nppc/ChillerControl/Firmware/CASCADE_LOGIC.md

# Внешний температурный контур

Внешний контур преобразует уставку жидкости `setTemp` в целевую температуру
воздуха в ящике `effectiveBoxTarget`. При активном iSpindel температура жидкости
является процессной величиной. Внутренние контуры нагрева и охлаждения следуют
за `effectiveBoxTarget` и этим документом не описываются.

Реализация находится в `CoolerBox/TemperatureControl.cpp`. Отчёты iSpindel
поступают из `CoolerBox/CoolerBox.cpp`; статусные поля сохраняют прежний внешний
интерфейс.

## Последовательность управления

1. `updateCascadeTarget()` обновляет рампу `setTemp` и фильтр скорости жидкости.
   Рампа и фильтр тренда работают как прежде.
2. PID внешнего контура запускается только при активном iSpindel и только один
   раз на новый отчёт. Повторный вызов `updateCascadeTarget()` для того же
   отчёта не меняет интеграл.
3. Цель воздуха проходит прежний ограничитель скорости изменения перед
   присваиванием `effectiveBoxTarget`.
4. Выбор режимов, блокировки и управление внутренними контурами в
   `processControl()` не менялись.

## Формула ПИД

Обозначения:

- `T` — `iSpindelTemperature`;
- `e = setTemp - T`;
- `rate` — отфильтрованная скорость изменения температуры жидкости, °C/ч;
- `I` — интегральная сумма QuickPID, соответствующая смещению воздуха относительно уставки.

Для нового отчёта:

```text
u_pi = outerPID_kP * e + I
u_d  = -outerPID_kP * clamp(outerPID_tdHours * rate,
                            -outerPID_forecastLimitC,
                            +outerPID_forecastLimitC)
u    = clamp(u_pi + u_d, -cascadeMaxOffset, +cascadeMaxOffset)
targetRaw = setTemp + u
```

Для P и I используется QuickPID в режиме `timer`, с `pOnError`, `dOnMeas`,
`iAwClamp` и прямым действием. Встроенный D отключён; D по фильтрованной скорости
рассчитывается отдельно. Перед каждым `Compute()` коэффициент Ki задаётся как
`outerPID_kIPerHour * dtHours`. `dtHours` вычисляется по времени между
обработанными отчётами и ограничивается снизу 30 секундами, сверху — 1.5
интервала iSpindel. Для первого отчёта используется настроенный интервал
iSpindel. Такой расчёт не использует микросекундный интервал QuickPID для
измерения фактического времени.

## Интегратор и состояния

- Начальное смещение `I` берётся из `boxTemp - setTemp`, ограниченного
  `±cascadeMaxOffset`. Если температура ящика ещё невалидна, начальное смещение
  равно нулю; при появлении валидного `boxTemp` интегратор инициализируется
  повторно. При переходе `useISpindelTemp` из `false` в `true` начальное
  смещение также считывается из текущего `boxTemp`.
- Смена `setTemp`, в том числе из-за шага рампы, сама по себе не сбрасывает
  интегратор.
- При активном iSpindel, если нового отчёта нет, сохраняется последний выход
  внешнего контура. Если iSpindel включён, но неактивен, цель равна
  `setTemp + I`; P и D не рассчитываются и интегратор не меняется.
- При выключенном `useISpindelTemp` цель напрямую равна `setTemp`; состояние
  PID сохраняется.
- Интегрирование замораживается, если направление, соответствующее знаку
  ошибки, недоступно, выполняется autotune нагрева либо жидкость достаточно
  быстро движется к цели (`e * rate > 0` и `abs(rate) > 0.1 °C/ч`). P и D при
  этом продолжают работать, а накопленная сумма I восстанавливается после
  `Compute()`.
- На каждом новом отчёте в Debug записываются ошибка, скорость, P, I, D,
  итоговое смещение и причина заморозки.

## Фильтр скорости и прогноз

На каждом новом активном отчёте фильтр скорости рассчитывает изменение
температуры в час, ограничивает исходную скорость диапазоном ±0.75 °C/ч и
обновляет экспоненциальное среднее с весом нового значения 0.15. При пропуске,
превышающем прежний допустимый интервал выборки, скорость сбрасывается в ноль.
Публичный `getPredictedFermenterTemp()` возвращает текущую температуру плюс
ограниченный прогноз `outerPID_tdHours * rate`.

## Совместимость публичного интерфейса

Сигнатуры и вызывающие их поверхности сохранены:

- `getHeatingCascadeGain()` и `getCoolingCascadeGain()` возвращают общий
  `outerPID_kP`;
- `getCascadeBoxBaseline()` возвращает `setTemp + I`;
- `cascadeMaxOffset`, `effectiveBoxTarget`, `iSpindelIntervalSec`, API рампы и
  остальные публичные функции не переименованы.

Проверка валидности iSpindel, выбор подрежима Auto и аварийные блокировки
сохранены без изменений на этапе 1. Значение температуры iSpindel 0 °C
допускается, если соблюдены диапазон и таймаут активности. Дополнительные
защиты и изменения режимов из этапа 2 здесь не реализованы.

## Настраиваемые параметры

Параметры внешнего PID и предел смещения задаются на странице PID, сохраняются
в EEPROM и проверяются по допустимым диапазонам. Для отключения D задайте
`outerPID_tdHours = 0`. Вклад D вычисляется вручную:
`-Kp * clamp(Td * rate, ±forecastLimit)`, поэтому `Td` задаёт горизонт
прогноза, а `forecastLimit` ограничивает прогнозную составляющую.

| Параметр | Начальное значение | Допустимый диапазон | Назначение |
| --- | ---: | --- |
| `outerPID_kP` | 2.0 | 0.1–10.0 | Пропорциональное усиление |
| `outerPID_kIPerHour` | 0.4 /ч | 0.001–2.0 /ч | Скорость интегрирования |
| `outerPID_tdHours` | 0.5 ч | 0–6.0 ч | Горизонт D-прогноза |
| `outerPID_forecastLimitC` | 0.25 °C | 0–2.0 °C | Ограничение D-прогноза |
| `outerPID_freezeRateCPerHour` | 0.1 °C/ч | 0–2.0 °C/ч | Порог скорости для заморозки I |
| `cascadeMaxOffset` | 4.0 °C | 1–10 °C | Предел смещения цели воздуха |
| `FERMENTER_MAX_RATE_C_PER_HOUR` | 0.75 °C/ч | — | Ограничение исходной скорости фильтра |
| `FERMENTER_RATE_FILTER_ALPHA` | 0.15 | — | Вес новой выборки фильтра |
| `BOX_TARGET_MAX_SLEW_UP_PER_SEC` | 0.08 °C/мин | — | Прежний предел роста цели воздуха |
| `BOX_TARGET_MAX_SLEW_DOWN_PER_SEC` | 0.12 °C/мин | — | Прежний предел снижения цели воздуха |
