nppc/ChillerControl/Images/componentsPlacement1.png

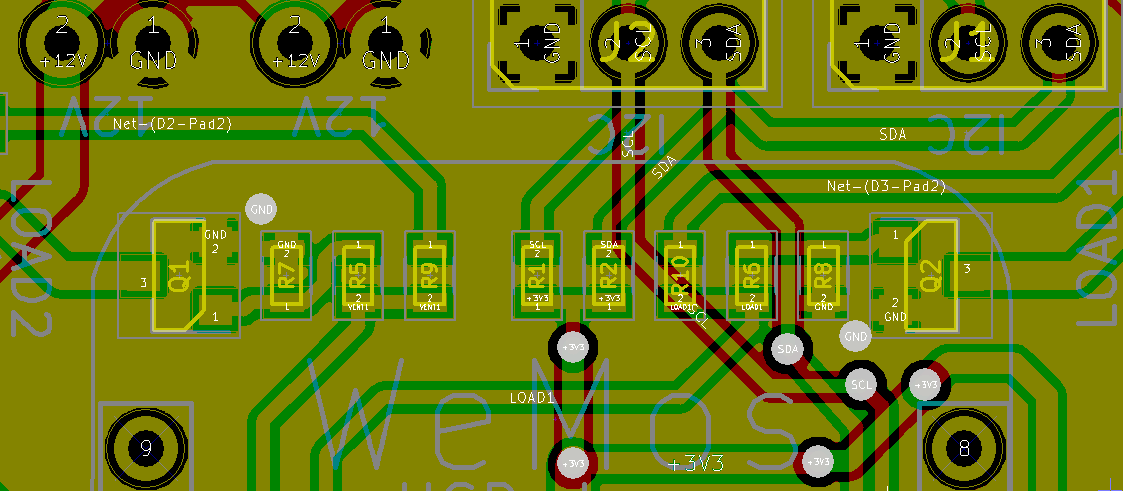
Images/componentsPlacement1.png
