nppc/ChillerControl/OpenSCAD/CoolerCover.stl

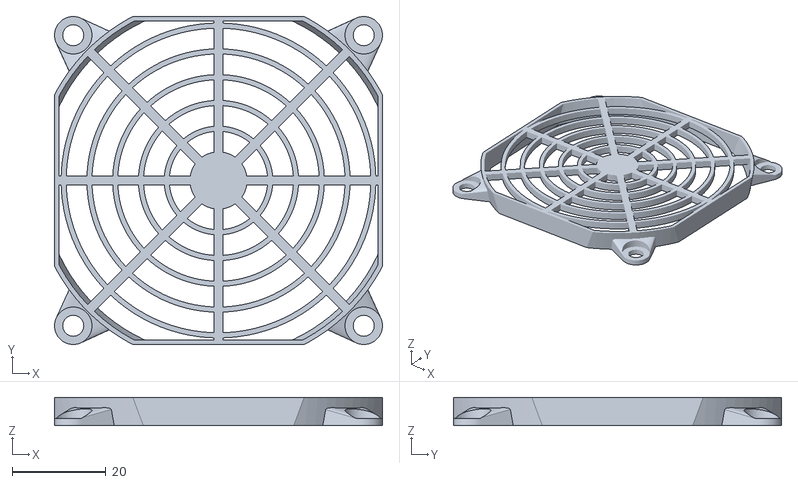
[picture p2: CAD file, 2018-10-02]
OpenSCAD/CoolerCover.stl
70.0 x 70.0 x 6.00
