nppc/ChillerControl/OpenSCAD/Lock.stl

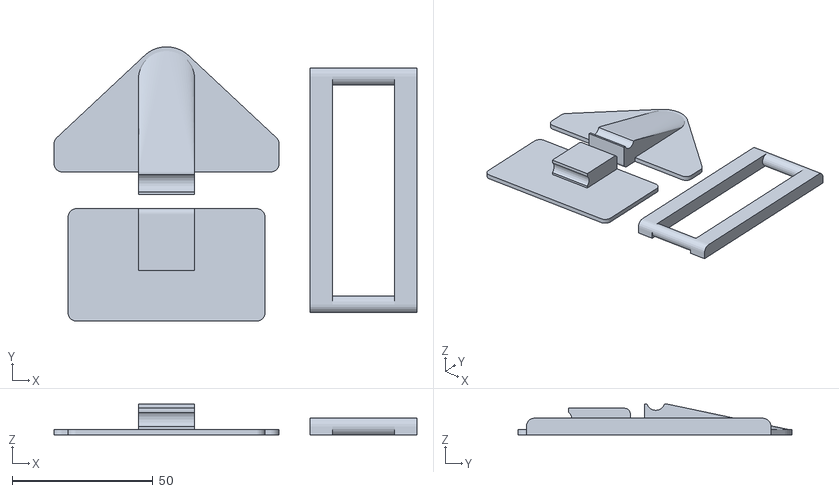
[picture p3: CAD file, 2018-09-29]
OpenSCAD/Lock.stl
129.0 x 97.5 x 11.0
