nppc/ChillerControl/OpenSCAD/CaseB.stl

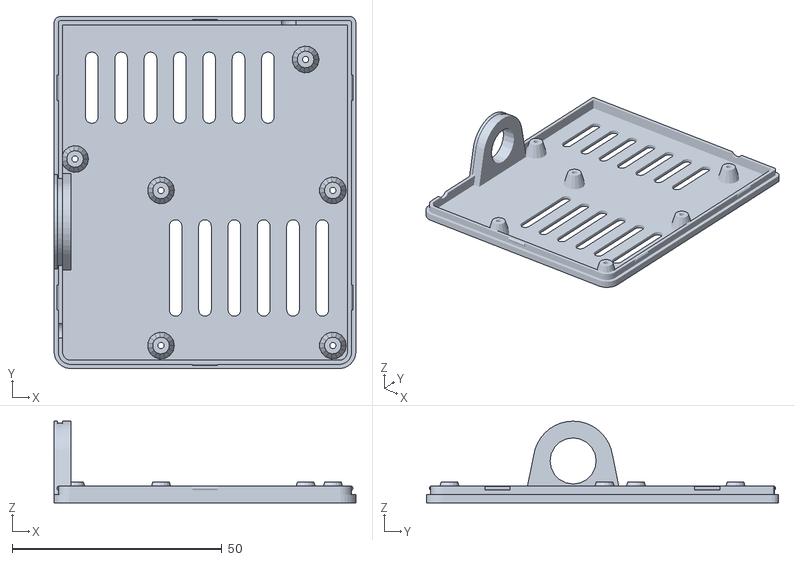
[picture p4: CAD file, 2018-09-15]
OpenSCAD/CaseB.stl
72.0 x 84.0 x 19.5
