nppc/ChillerControl/OpenSCAD/CaseT.stl

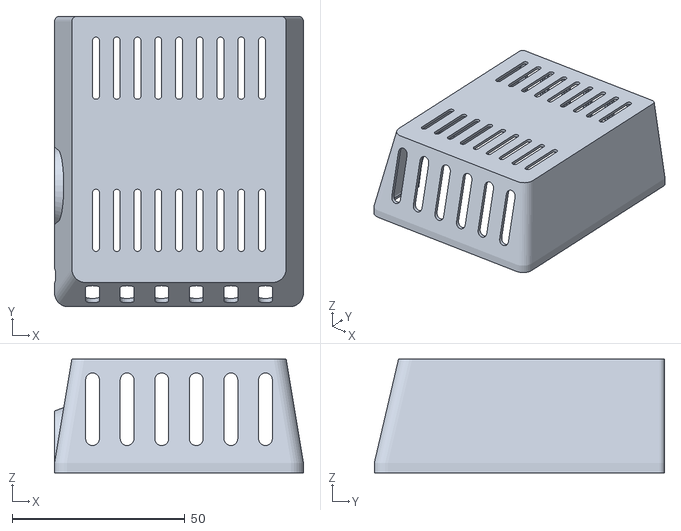
[picture p5: CAD file, 2018-09-15]
OpenSCAD/CaseT.stl
72.0 x 84.0 x 32.9
