nppc/ChillerControl/KiCad/Schematic.pdf

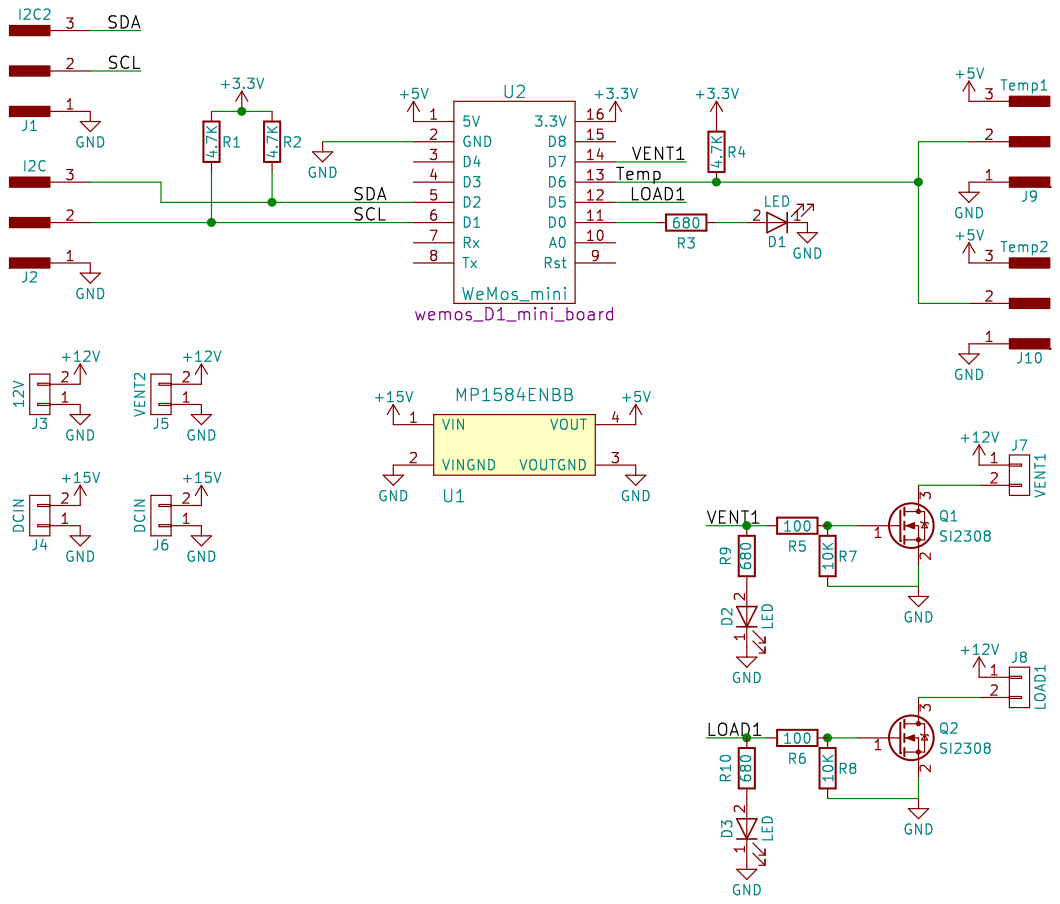
[picture p6: page 1]
