nppc/ChillerControl/KiCad/ChillerControl.kicad_pcb

## KiCad design KiCad/ChillerControl.kicad_pcb (2018-08-06)

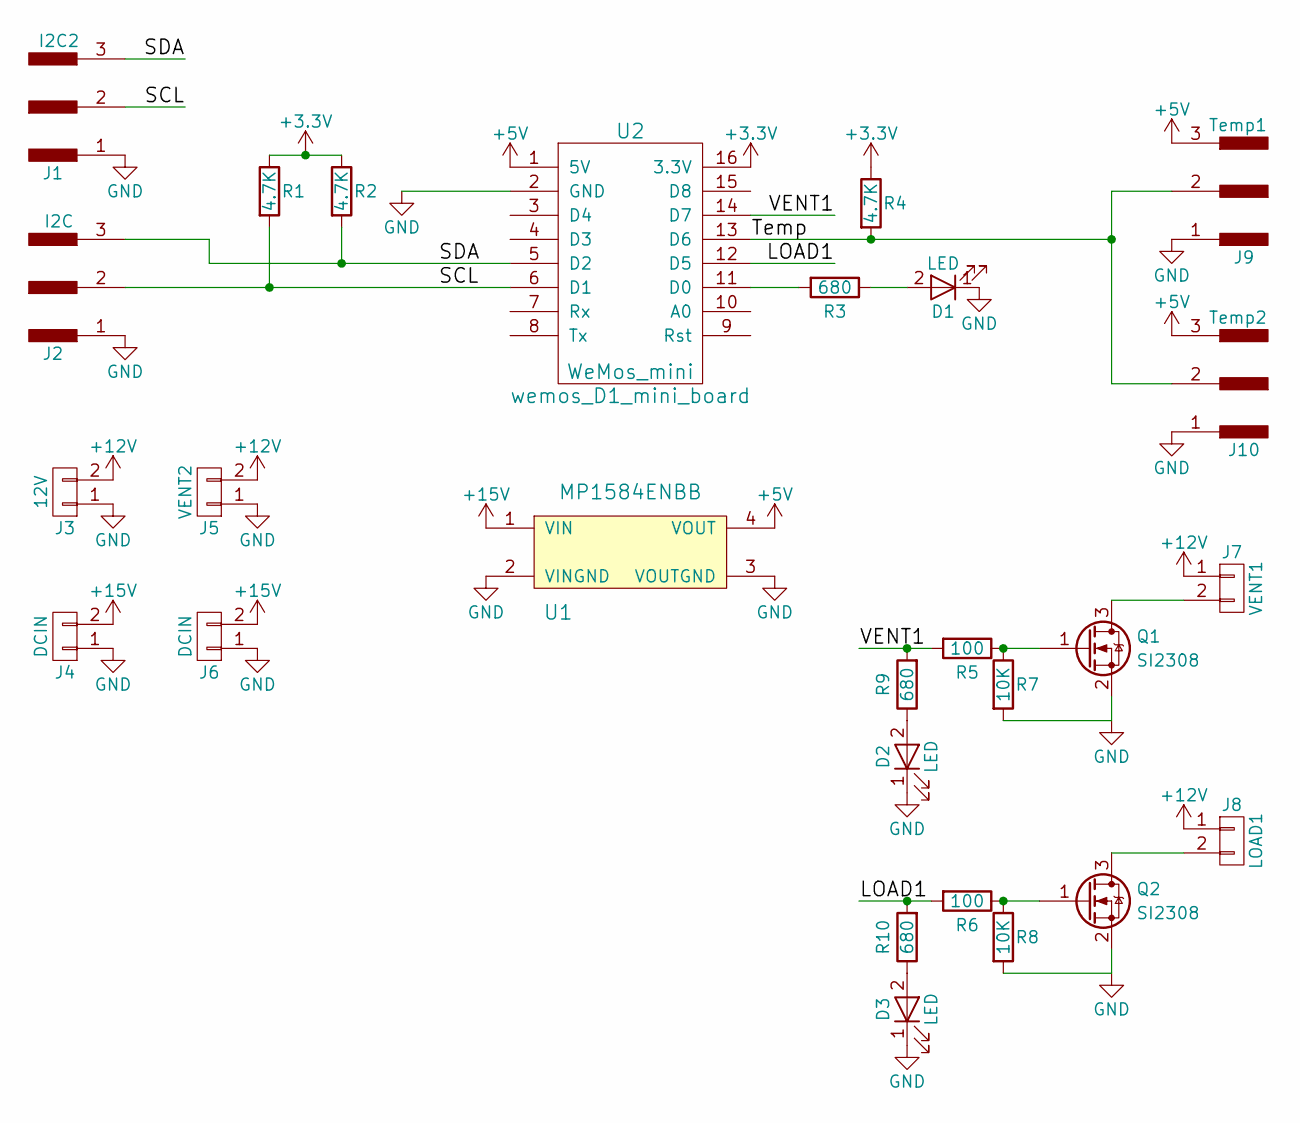
[picture p7: schematic ChillerControl-2019-03-04-20-39-42.sch]

Parts:
D1, D2, D3: LED; LED_0805
J1: I2C2; Pin_Header_Straight_1x03_Pitch2.54mm
J2: I2C; Pin_Header_Straight_1x03_Pitch2.54mm
J3: 12V; Conn2pin_2.54mm
J4, J6: DCIN; Conn_Power
J5: VENT2; Conn2pin_2.54mm
J7: VENT1; Conn2pin_2.54mm
J8: LOAD1; Conn2pin_2.54mm
J9: Temp1; Pin_Header_Straight_1x03_Pitch2.54mm
J10: Temp2; Pin_Header_Straight_1x03_Pitch2.54mm
Q1, Q2: SI2308; SOT-23
R1, R2, R4: 4.7K; R_0603
R3, R9, R10: 680; R_0603
R5, R6: 100; R_0603
R7, R8: 10K; R_0603
U1: MP1584ENBB; MP1584_buck_module
U2: WeMos_mini; wemos_D1_mini_board

Connections:
+3V3: R1.1, R2.1, R4.1, U2.16 (3.3V)
+5V: J9.3, J10.3, U1.4 (VOUT), U2.1 (5V)
+12V: J3.2, J5.2, J7.1, J8.1
+15V: J4.2, J6.2, U1.1 (VIN)
/LOAD1: R6.2, R10.2, U2.12 (D5)
/SCL: J1.2, J2.2, R1.2, U2.6 (D1)
/SDA: J1.3, J2.3, R2.2, U2.5 (D2)
/Temp: J9.2, J10.2, R4.2, U2.13 (D6)
/VENT1: R5.2, R9.2, U2.14 (D7)
GND: D1.1 (K), D2.1 (K), D3.1 (K), J1.1, J2.1, J3.1, J4.1, J5.1, J6.1, J9.1, J10.1, Q1.2 (S), Q2.2 (S), R7.2, R8.2, U1.2 (VINGND), U1.3 (VOUTGND), U2.2 (GND)
unnamed: D1.2 (A), R3.1
unnamed: D2.2 (A), R9.1
unnamed: D3.2 (A), R10.1
unnamed: J7.2, Q1.3 (D)
unnamed: J8.2, Q2.3 (D)
unnamed: Q1.1 (G), R5.1, R7.1
unnamed: Q2.1 (G), R6.1, R8.1
unnamed: R3.2, U2.11 (D0)

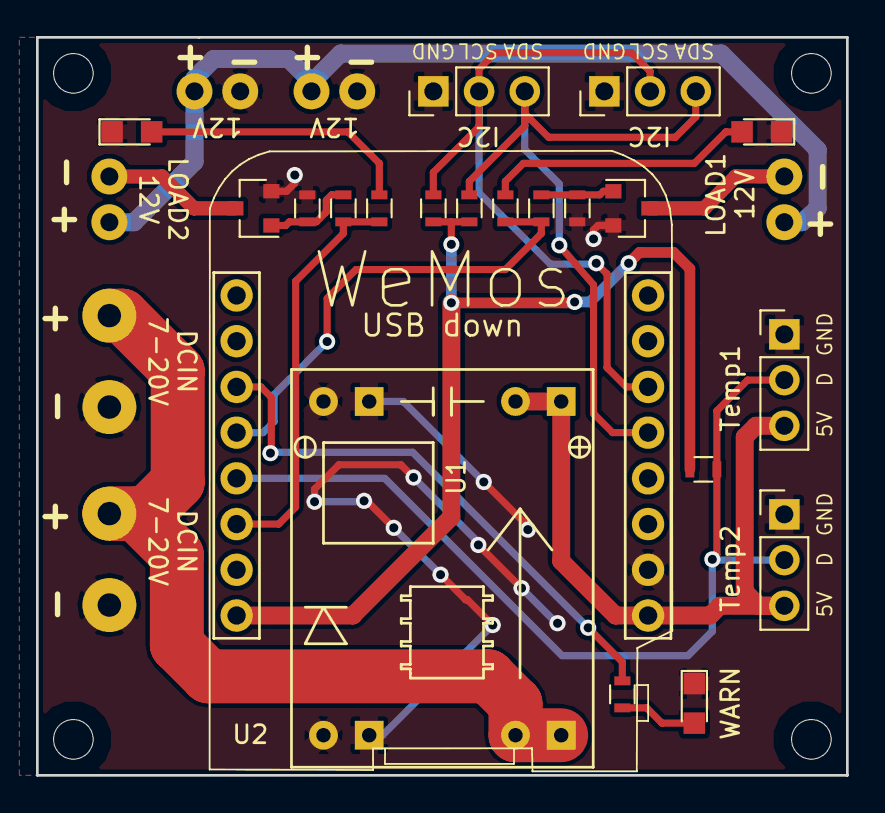
[picture p8: board ChillerControl.kicad_pcb from above]

Board: 2 copper layers, 45.0 x 41.0 mm, 27 parts (0 on the bottom side), 18 nets.
