nppc/ChillerControl/Firmware/data/main.js

let requestedSetTemp = null;
const RAMP_UP_ICON = '<svg class="target-ramp-icon" viewBox="0 0 20 20" aria-hidden="true"><path d="M3 3.5h14M4 15.5l4-3.5 3 1 4.5-7"/><path d="M12.5 6H16v3.5"/></svg>';
const RAMP_DOWN_ICON = '<svg class="target-ramp-icon" viewBox="0 0 20 20" aria-hidden="true"><path d="M3 16.5h14M4 4.5l4 3.5 3-1 4.5 7"/><path d="M12.5 14H16v-3.5"/></svg>';

function NumberChange(n, i) {
  const el = document.getElementById(i);
  if (!el) return;
  if (!el.value || el.value === '') {
    const setTempEl = document.getElementById('setTemp');
    const current = setTempEl ? parseFloat(setTempEl.textContent) : 19.0;
    el.value = (isNaN(current) ? 19.0 : current).toFixed(1);
  }
  el.stepUp(n);
}

function setupNavigation() {
  const container = document.querySelector('.container');
  if (!container) return;

  const oldHeader = container.querySelector('.hdr_table');
  const caption = oldHeader && oldHeader.querySelector('.hdr_caption');
  const header = document.createElement('header');
  header.className = 'app-header';

  const menuButton = document.createElement('button');
  menuButton.type = 'button';
  menuButton.className = 'menu-toggle';
  menuButton.id = 'menuBtn';
  menuButton.setAttribute('aria-label', 'Open navigation menu');
  menuButton.setAttribute('aria-controls', 'sideMenu');
  menuButton.setAttribute('aria-expanded', 'false');
  menuButton.textContent = '\u2630';

  const brandCopy = document.createElement('div');
  brandCopy.className = 'brand-copy';
  const brandName = document.createElement('div');
  brandName.className = 'brand-name';
  brandName.textContent = 'COOLER BOX';
  const title = document.createElement('h1');
  title.id = 'appTitle';
  title.textContent = caption ? caption.textContent.trim() : document.title;
  brandCopy.append(brandName, title);

  const headerStatus = document.createElement('div');
  headerStatus.className = 'header-status';
  headerStatus.id = 'headerStatus';
  headerStatus.innerHTML = `
    <div class="wifi-indicators">
      <div class="wifi-status signal-0" id="wifiStatus" aria-label="Box Wi-Fi disconnected" title="Box Wi-Fi">
        <svg class="wifi-icon" viewBox="0 0 32 32" aria-hidden="true">
          <path class="wifi-arc wifi-arc-outer" d="M3 11.5a19 19 0 0 1 26 0"/>
          <path class="wifi-arc wifi-arc-middle" d="M7.5 16a12.5 12.5 0 0 1 17 0"/>
          <path class="wifi-arc wifi-arc-inner" d="M12 20.5a6 6 0 0 1 8 0"/>
          <circle class="wifi-dot" cx="16" cy="25" r="2.2"/>
        </svg>
        <span class="wifi-label">Box:</span><span id="rssiValue">-- dBm</span>
      </div>
    </div>
    <div class="uptime-status"><span class="uptime-label">Up: </span><span id="CurTime">--</span></div>
  `;

  header.append(menuButton, brandCopy, headerStatus);
  container.insertBefore(header, container.firstChild);

  const menu = document.createElement('nav');
  menu.id = 'sideMenu';
  menu.setAttribute('aria-label', 'Main navigation');
  const menuHeading = document.createElement('h2');
  menuHeading.textContent = 'Menu';
  menu.appendChild(menuHeading);

  const menuItems = [
    ['Home', '/'],
    ['Settings', '/settings'],
    ['PID tuning', '/pids'],
    ['Network', '/network'],
    ['Diagnostics', '/debug'],
    ['Firmware update', '/update']
  ];
  menuItems.forEach(([label, href]) => {
    const link = document.createElement('a');
    link.className = 'menu-item';
    link.href = href;
    link.textContent = label;
    if (window.location.pathname === href ||
        (href === '/' && window.location.pathname === '/index.htm')) {
      link.setAttribute('aria-current', 'page');
    }
    menu.appendChild(link);
  });

  const backdrop = document.createElement('button');
  backdrop.type = 'button';
  backdrop.id = 'sideMenuBackdrop';
  backdrop.setAttribute('aria-label', 'Close navigation menu');
  document.body.append(menu, backdrop);

  const closeMenu = () => {
    menu.classList.remove('open');
    backdrop.classList.remove('open');
    menuButton.setAttribute('aria-expanded', 'false');
    menuButton.setAttribute('aria-label', 'Open navigation menu');
  };
  menuButton.addEventListener('click', () => {
    const isOpen = menu.classList.toggle('open');
    backdrop.classList.toggle('open', isOpen);
    menuButton.setAttribute('aria-expanded', String(isOpen));
    menuButton.setAttribute('aria-label', isOpen ? 'Close navigation menu' : 'Open navigation menu');
    if (isOpen) menu.querySelector('a').focus();
  });
  backdrop.addEventListener('click', closeMenu);
  menu.addEventListener('click', (event) => {
    if (event.target.closest('a')) closeMenu();
  });
  document.addEventListener('keydown', (event) => {
    if (event.key === 'Escape') {
      const stopModal = document.getElementById('stopModalBackdrop');
      if (stopModal && stopModal.style.display !== 'none') {
        closeStopModal();
        return;
      }
      const modal = document.getElementById('tempModalBackdrop');
      if (modal && modal.style.display !== 'none') {
        closeTempModal();
        return;
      }
      if (menu.classList.contains('open')) {
        closeMenu();
        menuButton.focus();
      }
    }
  });

  if (caption) {
    new MutationObserver(() => {
      title.textContent = caption.textContent.trim();
    }).observe(caption, { childList: true, characterData: true, subtree: true });
  }

  if (!document.getElementById('boxTemp')) {
    fetch('/status')
      .then(r => r.ok ? r.json() : null)
      .then(data => { if (data) updateHeaderStatus(data); })
      .catch(() => {});

    setInterval(() => {
      if (!document.hidden) {
        fetch('/status')
          .then(r => r.ok ? r.json() : null)
          .then(data => { if (data) updateHeaderStatus(data); })
          .catch(() => {});
      }
    }, 5000);
  }
}

function updateHeaderStatus(data) {
  const curTime = document.getElementById('CurTime');
  if (curTime && data.CurTime !== undefined) {
    curTime.textContent = data.CurTime;
  }
  const wifiStatus = document.getElementById('wifiStatus');
  const rssiValue = document.getElementById('rssiValue');
  if (wifiStatus && rssiValue) {
    const connected = data.wifiConnected === true && Number.isFinite(Number(data.rssi));
    const rssi = connected ? Number(data.rssi) : null;
    const signalLevel = !connected ? 0 : rssi >= -55 ? 4 : rssi >= -67 ? 3 : rssi >= -75 ? 2 : 1;
    wifiStatus.className = `wifi-status signal-${signalLevel}`;
    wifiStatus.setAttribute('aria-label', connected ? `Box Wi-Fi signal ${rssi} dBm` : 'Box Wi-Fi disconnected');
    rssiValue.textContent = connected ? `${rssi} dBm` : (data.emergencyMode ? 'Emergency AP' : '-- dBm');
  }

  const ispindelStatus = document.getElementById('ispindelWifiStatus');
  const ispindelRssiValue = document.getElementById('ispindelRssiValue');
  const ispindelPlatoValue = document.getElementById('ispindelPlatoValue');
  const ispindelFermentStatus = document.getElementById('ispindelFermentStatus');
  const ispindelFermentInfo = document.getElementById('ispindelFermentInfo');
  if (ispindelStatus && ispindelRssiValue) {
    if (data.useISpindelTemp && data.isISpindelActive) {
      ispindelStatus.style.display = 'inline-flex';
      const hasRssi = Number.isFinite(Number(data.iSpindelRssi)) && Number(data.iSpindelRssi) !== 0;
      if (hasRssi) {
        const iRssi = Number(data.iSpindelRssi);
        const iLevel = iRssi >= -55 ? 4 : iRssi >= -67 ? 3 : iRssi >= -75 ? 2 : 1;
        ispindelStatus.className = `wifi-status signal-${iLevel} ispindel-badge`;
        ispindelStatus.setAttribute('aria-label', `iSpindel Wi-Fi signal ${iRssi} dBm`);
        ispindelRssiValue.textContent = `${iRssi} dBm`;
      } else {
        ispindelStatus.className = 'wifi-status signal-0 ispindel-badge';
        ispindelStatus.setAttribute('aria-label', 'iSpindel offline');
        ispindelRssiValue.textContent = 'online';
      }
      if (ispindelFermentInfo) {
        ispindelFermentInfo.style.display = 'inline-flex';
      }
      if (ispindelPlatoValue) {
        const plato = data.iSpindelPlato && data.iSpindelPlato !== '' ? data.iSpindelPlato : null;
        if (plato !== null) {
          ispindelPlatoValue.textContent = `(${plato}\u00B0P)`;
          ispindelPlatoValue.style.display = 'inline';
        } else {
          ispindelPlatoValue.style.display = 'none';
        }
      }
      if (ispindelFermentStatus) {
        if (data.fermentationComplete === true) {
          ispindelFermentStatus.className = 'ferment-done-tag';
          ispindelFermentStatus.textContent = 'Finished';
          ispindelFermentStatus.title = 'Fermentation stable for 48h';
          ispindelFermentStatus.style.display = 'inline-block';
        } else if (Number.isFinite(Number(data.fermentationHours)) && Number(data.fermentationHours) < 6) {
          ispindelFermentStatus.className = 'ferment-stable-tag';
          ispindelFermentStatus.textContent = 'Gathering history';
          ispindelFermentStatus.title = `Gathering initial history (${data.fermentationHours || 0}/6h)`;
          ispindelFermentStatus.style.display = 'inline-block';
        } else if (Number.isFinite(Number(data.stableHours)) && Number(data.stableHours) >= 6) {
          ispindelFermentStatus.className = 'ferment-stable-tag';
          ispindelFermentStatus.textContent = `Stable: ${data.stableHours}h`;
          ispindelFermentStatus.title = `Plato stable for ${data.stableHours} hours`;
          ispindelFermentStatus.style.display = 'inline-block';
        } else {
          ispindelFermentStatus.className = 'ferment-stable-tag';
          ispindelFermentStatus.textContent = 'Fermenting';
          ispindelFermentStatus.title = 'Fermentation active';
          ispindelFermentStatus.style.display = 'inline-block';
        }
      }
    } else {
      ispindelStatus.style.display = 'none';
      if (ispindelFermentInfo) ispindelFermentInfo.style.display = 'none';
      if (ispindelPlatoValue) ispindelPlatoValue.style.display = 'none';
      if (ispindelFermentStatus) ispindelFermentStatus.style.display = 'none';
    }
  }
}

function openTempModal() {
  const backdrop = document.getElementById('tempModalBackdrop');
  if (!backdrop) return;
  const tempInput = document.getElementById('Temp');
  const setTempEl = document.getElementById('setTemp');
  if (tempInput) {
    const current = requestedSetTemp !== null
      ? requestedSetTemp
      : (setTempEl ? parseFloat(setTempEl.textContent) : NaN);
    if (!isNaN(current)) tempInput.value = current.toFixed(1);
  }
  const rampMode = document.querySelector('input[name="rampMode"]:checked');
  const rampFields = document.getElementById('rampRateFields');
  if (rampFields) {
    const ramping = rampMode && rampMode.value === 'rate';
    rampFields.hidden = !ramping;
    rampFields.querySelectorAll('input').forEach(input => {
      input.disabled = !ramping;
    });
  }
  backdrop.style.display = 'flex';
  setTimeout(() => {
    backdrop.classList.add('open');
    if (tempInput) {
      tempInput.focus();
      tempInput.select();
    }
  }, 10);
}

function closeTempModal(event) {
  if (event && event.target && event.target.id !== 'tempModalBackdrop' && !event.target.classList.contains('modal-close') && !event.target.classList.contains('modal-btn')) {
    return;
  }
  const backdrop = document.getElementById('tempModalBackdrop');
  if (!backdrop) return;
  backdrop.classList.remove('open');
  setTimeout(() => {
    backdrop.style.display = 'none';
  }, 180);
}

function openStopModal() {
  const backdrop = document.getElementById('stopModalBackdrop');
  if (!backdrop) return;
  backdrop.style.display = 'flex';
  setTimeout(() => {
    backdrop.classList.add('open');
    const confirmButton = document.getElementById('confirmStopBtn');
    if (confirmButton) confirmButton.focus();
  }, 10);
}

function closeStopModal(event) {
  if (event && event.target && event.target.id !== 'stopModalBackdrop' && !event.target.classList.contains('modal-close') && !event.target.classList.contains('modal-btn')) {
    return;
  }
  const backdrop = document.getElementById('stopModalBackdrop');
  if (!backdrop) return;
  backdrop.classList.remove('open');
  setTimeout(() => {
    backdrop.style.display = 'none';
    const controlBtn = document.getElementById('controlBtn');
    if (controlBtn) controlBtn.focus();
  }, 180);
}

function showhide() {
  openTempModal();
}

let statusPollTimer = null;
let currentPollInterval = 2000;
let goodSignalCounter = 0;

async function updateStatus() {
  let nextDelay = currentPollInterval;
  const controller = new AbortController();
  const timeoutId = setTimeout(() => controller.abort(), 4000);

  try {
    const res = await fetch('/status', { signal: controller.signal });
    clearTimeout(timeoutId);
    if (!res.ok) {
      currentPollInterval = 5000;
      goodSignalCounter = 0;
      return;
    }
    const data = await res.json();

    // Adapt refresh rate based on RSSI with hysteresis
    if (typeof data.rssi === 'number') {
      if (data.rssi <= -80) {
        currentPollInterval = 5000; // Slow down on weak signal (<= -80 dBm)
        goodSignalCounter = 0;
      } else if (data.rssi >= -75) {
        goodSignalCounter++;
        if (goodSignalCounter >= 5) { // Require 5 consecutive good readings before switching to 2 seconds
          currentPollInterval = 2000;
        }
      } else {
        goodSignalCounter = 0;
      }
    }
    nextDelay = currentPollInterval;

    updateHeaderStatus(data);

    const setIf = (id, val) => {
      const el = document.getElementById(id);
      if (el && val !== undefined) el.textContent = val;
    };

    setIf('Caption', data.Caption);
    const activeProcess = data.activeProcess || 'stopped';
    setIf('operationLabel', data.activeProcess === 'cooling' ? 'Cooling' :
      data.activeProcess === 'heating' ? (data.autoTuning ? 'Heating tune' : 'Heating') : 'Stopped');
    const boxModeCard = document.getElementById('boxModeCard');
    if (boxModeCard) boxModeCard.className = `box-mode-card ${activeProcess}`;
    const boxModePill = document.getElementById('boxModePill');
    if (boxModePill) boxModePill.className = `box-mode-pill ${activeProcess}`;
    const coolingActive = data.activeProcess === 'cooling';
    const heatingActive = data.activeProcess === 'heating';
    const heatingMetrics = document.getElementById('heatingMetrics');
    const coolingMetrics = document.getElementById('coolingMetrics');
    if (heatingMetrics) heatingMetrics.style.display = heatingActive ? 'inline-flex' : 'none';
    if (coolingMetrics) coolingMetrics.style.display = coolingActive ? 'inline-flex' : 'none';
    setIf('HotTemp', data.HotTemp);
    setIf('boxTemp', data.boxTemp);
    setIf('effectiveBoxTarget', data.effectiveBoxTarget);
    setIf('setHotPWM', data.setHotPWM);
    setIf('Voltage', data.Voltage);
    setIf('Current', data.Current);

    const isISpindel = data.isISpindelActive === true;
    const primaryLabel = document.getElementById('primaryTempLabel');
    const primaryBaseLabel = document.getElementById('primaryTempBaseLabel');
    const primaryVal = document.getElementById('primaryTemp');
    const primarySub = document.getElementById('primaryTempSub');
    const targetLabel = document.getElementById('targetTempLabel');
    const cascadeBar = document.getElementById('cascadeBar');

    if (isISpindel) {
      if (primaryBaseLabel) primaryBaseLabel.textContent = 'Fermenter ';
      else if (primaryLabel) primaryLabel.textContent = 'Fermenter ';
      if (primaryVal) primaryVal.textContent = data.iSpindelTemp;
      if (targetLabel) targetLabel.textContent = 'Fermenter Target';
      if (primarySub) {
        const ageMin = Math.floor((data.iSpindelAgeSec || 0) / 60);
        const intMin = Math.round((data.iSpindelInterval || 0) / 60);
        primarySub.textContent = `Updated ${ageMin}m ago \u00b7 Interval: ${intMin}m`;
      }
      if (cascadeBar) cascadeBar.style.display = 'flex';
    } else {
      if (primaryBaseLabel) primaryBaseLabel.textContent = 'Box Temperature';
      else if (primaryLabel) primaryLabel.textContent = 'Box Temperature';
      if (primaryVal) primaryVal.textContent = data.boxTemp;
      if (targetLabel) targetLabel.textContent = 'Target';
      if (primarySub) {
        primarySub.textContent = data.useISpindelTemp
          ? 'iSpindel offline \u00b7 Controlling by box'
          : 'Direct box control';
      }
      if (cascadeBar) cascadeBar.style.display = 'none';
    }

    if (data.pendingBootAutoStart && primarySub) {
      const waitMins = Math.max(1, Math.ceil((data.bootAutoStartSec || 0) / 60));
      primarySub.textContent = `Waiting for iSpindel \u00b7 Auto-starts in ${waitMins}m`;
    }

    const fanEl = document.getElementById('Fan');
    if (fanEl && data.Fan !== undefined) {
      fanEl.textContent = data.Fan;
      const isOn = data.Fan === 'On';
      fanEl.classList.toggle('on', isOn);
      const fanIcon = document.querySelector('.fan-icon');
      if (fanIcon) fanIcon.classList.toggle('spinning', isOn);
    }

    const setTempEl = document.getElementById('setTemp');
    if (setTempEl && data.setTemp !== undefined) {
      setTempEl.textContent = data.setTemp;
    }
    if (data.rawSetTemp !== undefined) {
      requestedSetTemp = parseFloat(data.rawSetTemp);
    }
    const rampStatus = document.getElementById('targetRampStatus');
    const rampIcon = document.getElementById('targetRampIcon');
    const rampRate = document.getElementById('targetRampRate');
    const targetDisplayLabel = document.getElementById('targetTempLabel');
    if (rampStatus && rampIcon && rampRate && targetDisplayLabel) {
      const stepC = Number(data.rampStepC);
      const intervalMinutes = Number(data.rampIntervalMinutes);
      const rampTargetTemp = Number(data.rampTargetTemp);
      const currentSetTemp = Number(data.setTemp);
      const isRamping = data.isSetTempRamping === true &&
        Number.isFinite(stepC) && Number.isFinite(intervalMinutes) &&
        Number.isFinite(rampTargetTemp) && Number.isFinite(currentSetTemp);
      rampStatus.hidden = !isRamping;
      if (isRamping) {
        const stepText = stepC.toFixed(2).replace(/0+$/, '').replace(/\.$/, '');
        rampRate.textContent = `${stepText}\u00B0C / ${intervalMinutes} min`;
        targetDisplayLabel.textContent = `Target: ${rampTargetTemp.toFixed(1)}\u00B0C`;
        const rampingUp = rampTargetTemp > currentSetTemp;
        rampIcon.innerHTML = rampingUp ? RAMP_UP_ICON : RAMP_DOWN_ICON;
      } else {
        rampIcon.textContent = '';
        targetDisplayLabel.textContent = data.isISpindelActive ? 'Fermenter Target' : 'Target';
      }
    }

    const controlBtn = document.getElementById('controlBtn');
    const controlForm = document.getElementById('controlForm');
    if (controlBtn && controlForm) {
      controlBtn.disabled = data.autoTuning === true;
      if (data.autoTuning) {
        controlBtn.textContent = 'AUTOTUNE';
        controlBtn.className = 'btn btn_action_control btn_muted';
      } else if (data.stopping) {
        controlBtn.textContent = 'START';
        controlBtn.className = 'btn btn_action_control btn_green';
        controlForm.action = '/start';
      } else {
        controlBtn.textContent = 'STOP';
        controlBtn.className = 'btn btn_action_control btn_red';
        controlForm.action = '/stop';
      }
    }

    const setTempPanel = document.getElementById('tempModalBackdrop');
    const isEditing = setTempPanel && setTempPanel.style.display !== 'none';
    const tempInput = document.getElementById('Temp');
    if (tempInput && data.rawSetTemp !== undefined && !isEditing && document.activeElement !== tempInput) {
      tempInput.value = data.rawSetTemp;
    }
  } catch (e) {
    clearTimeout(timeoutId);
    currentPollInterval = 5000;
    goodSignalCounter = 0;
    nextDelay = 5000;
  } finally {
    if (document.getElementById('boxTemp')) {
      clearTimeout(statusPollTimer);
      statusPollTimer = setTimeout(updateStatus, nextDelay);
    }
  }
}

function setupIndexPage() {
  updateStatus();

  const tempForm = document.getElementById('setTempForm');
  if (tempForm) {
    tempForm.addEventListener('submit', async (e) => {
      e.preventDefault();
      const tempInput = document.getElementById('Temp');
      if (!tempInput || !tempInput.value) return;
      const val = parseFloat(tempInput.value);
      if (isNaN(val) || val < 0 || val > 45) {
        alert('Please enter a temperature between 0.0 and 45.0 \u00B0C');
        return;
      }
      const setBtn = tempForm.querySelector('button[type="submit"]');
      if (setBtn) setBtn.disabled = true;

      try {
        const params = new URLSearchParams(new FormData(tempForm));
        params.set('Temp', val.toFixed(1));
        const res = await fetch('/setTemp?' + params.toString());
        if (res.ok) {
          closeTempModal();
        } else {
          const error = await res.json().catch(() => null);
          alert(error && error.message ? error.message : 'Unable to set temperature.');
        }
      } catch (err) {
        alert('Unable to reach the chiller. Please try again.');
      } finally {
        if (setBtn) setBtn.disabled = false;
        await updateStatus();
      }
    });
  }

  const controlForm = document.getElementById('controlForm');
  const rampModes = tempForm.querySelectorAll('input[name="rampMode"]');
  const rampFields = document.getElementById('rampRateFields');
  if (rampFields) {
    rampModes.forEach(rampMode => {
      rampMode.addEventListener('change', () => {
        const ramping = rampMode.value === 'rate';
        rampFields.hidden = !ramping;
        rampFields.querySelectorAll('input').forEach(input => {
          input.disabled = !ramping;
        });
      });
    });
  }
  if (controlForm) {
    controlForm.addEventListener('submit', async (e) => {
      e.preventDefault();
      const isStopping = (controlForm.action.indexOf('/stop') >= 0);
      if (isStopping) {
        openStopModal();
        return;
      }
      try {
        await fetch('/start');
        await updateStatus();
      } catch (err) {}
    });
  }

  const confirmStopBtn = document.getElementById('confirmStopBtn');
  if (confirmStopBtn) {
    confirmStopBtn.addEventListener('click', async () => {
      confirmStopBtn.disabled = true;
      try {
        const res = await fetch('/stop');
        if (res.ok) closeStopModal();
        await updateStatus();
      } catch (err) {
      } finally {
        confirmStopBtn.disabled = false;
      }
    });
  }
}

async function setupSettingsPage() {
  try {
    const res = await fetch('/api/settings');
    if (!res.ok) return;
    const data = await res.json();

    const setIf = (id, val) => {
      const el = document.getElementById(id);
      if (el && val !== undefined) el.value = val;
    };

    const capEl = document.getElementById('Caption');
    if (capEl && data.Caption) capEl.textContent = data.Caption;

    setIf('VoltChange', data.changeVoltageSpeed);
    setIf('VoltMin', data.minVoltage);
    setIf('VoltMax', data.maxVoltage);
    setIf('platoSlope', data.platoStabilitySlopePerDay !== undefined ? Number(data.platoStabilitySlopePerDay).toFixed(2) : '0.10');

    if (data.boxMode) {
      const radio = document.querySelector(`input[name="boxMode"][value="${data.boxMode}"]`);
      if (radio) radio.checked = true;
    }

    if (data.useISpindelTemp !== undefined) {
      const val = data.useISpindelTemp ? "1" : "0";
      const radio = document.querySelector(`input[name="useISpindel"][value="${val}"]`);
      if (radio) radio.checked = true;
    }

    const populateSensors = (selectId, selectedId) => {
      const sel = document.getElementById(selectId);
      if (!sel) return;
      sel.innerHTML = '';
      if (!data.sensors || data.sensors.length === 0) {
        sel.innerHTML = "<option value='' disabled selected>No sensors detected</option>";
        return;
      }
      data.sensors.forEach(s => {
        const opt = document.createElement('option');
        opt.value = s.id;
        if (s.id === selectedId) opt.selected = true;
        opt.textContent = `${s.addr} = ${s.temp.toFixed(2)}\u00B0 C`;
        sel.appendChild(opt);
      });
    };

    populateSensors('SelColdSensor', data.ColdSensorId);
    populateSensors('SelHotSensor', data.HotSensorId);
  } catch (e) {}
}

let autotuneTimer = null;
let isAutotuning = false;

function initAutotuneTarget(targetVal) {
  const targetInput = document.getElementById('atTargetTemp');
  if (!targetInput) return;
  if (!targetInput.dataset.userEdited) {
    const saved = localStorage.getItem('autotune_target');
    const val = saved ? parseFloat(saved) : (targetVal || 19.0);
    if (!isNaN(val)) {
      targetInput.value = val.toFixed(1);
    }
  }
  if (!targetInput.dataset.listenerAttached) {
    targetInput.dataset.listenerAttached = 'true';
    targetInput.addEventListener('input', () => {
      targetInput.dataset.userEdited = 'true';
      const v = parseFloat(targetInput.value);
      if (!isNaN(v) && v >= 5 && v <= 45) {
        localStorage.setItem('autotune_target', v.toFixed(1));
      }
    });
  }
}

function initAutotunePwm(pwmVal) {
  const pwmInput = document.getElementById('atTestPWM');
  if (!pwmInput) return;
  if (!pwmInput.dataset.userEdited) {
    const saved = localStorage.getItem('autotune_pwm');
    const val = saved ? parseInt(saved, 10) : (pwmVal || 300);
    if (!isNaN(val)) {
      pwmInput.value = val;
    }
  }
  if (!pwmInput.dataset.listenerAttached) {
    pwmInput.dataset.listenerAttached = 'true';
    pwmInput.addEventListener('input', () => {
      pwmInput.dataset.userEdited = 'true';
      const v = parseInt(pwmInput.value, 10);
      if (!isNaN(v) && v >= 100 && v <= 700) {
        localStorage.setItem('autotune_pwm', v.toString());
      }
    });
  }
}

async function pollAutotuneStatus() {
  try {
    const res = await fetch('/api/autotune');
    if (!res.ok) return;
    const data = await res.json();

    const btn = document.getElementById('btnAutotune');
    const statusBox = document.getElementById('atStatusBox');
    const detailsBox = document.getElementById('atDetailsBox');
    const targetInput = document.getElementById('atTargetTemp');
    const pwmInput = document.getElementById('atTestPWM');

    isAutotuning = data.active;
    if (btn) {
      if (data.active) {
        btn.textContent = 'Stop Autotune';
        btn.className = 'btn btn_round btn_red';
      } else {
        btn.textContent = 'Start Autotune';
        btn.className = 'btn btn_round btn_green';
      }
    }

    if (targetInput) {
      if (data.active && data.targetTemp !== undefined) {
        targetInput.value = parseFloat(data.targetTemp).toFixed(1);
      } else {
        initAutotuneTarget(data.targetTemp || data.setTemp);
      }
    }

    if (pwmInput) {
      if (data.active && data.testPWM !== undefined) {
        pwmInput.value = parseInt(data.testPWM, 10);
      } else {
        initAutotunePwm(data.testPWM || 300);
      }
    }

    if (statusBox) {
      statusBox.textContent = `Status: ${data.message || data.stateStr}`;
    }

    if (detailsBox) {
      if (data.active) {
        detailsBox.textContent = `Cycle ${data.cycle}/${data.targetCycles} | Temp: ${data.currentTemp.toFixed(2)}\u00B0C (Pk: ${data.peakTemp.toFixed(2)}\u00B0C, Vl: ${data.valleyTemp.toFixed(2)}\u00B0C)`;
      } else if (data.calculatedKp > 0) {
        detailsBox.textContent = `Calculated: Kp=${data.calculatedKp.toFixed(2)}, Ki=${data.calculatedKi.toFixed(4)}, Kd=${data.calculatedKd.toFixed(2)}`;
        const setIf = (id, val) => {
          const el = document.getElementById(id);
          if (el && val !== undefined) el.value = val;
        };
        setIf('hotPID_kP', data.calculatedKp.toFixed(1));
        setIf('hotPID_kI', data.calculatedKi.toFixed(3));
        setIf('hotPID_kD', data.calculatedKd.toFixed(1));
      } else {
        detailsBox.textContent = '';
      }
    }
  } catch (e) {}
}

async function toggleAutotune() {
  const targetTempInput = document.getElementById('atTargetTemp');
  const targetTemp = targetTempInput && targetTempInput.value ? parseFloat(targetTempInput.value) : 20.0;
  if (!isNaN(targetTemp)) {
    localStorage.setItem('autotune_target', targetTemp.toFixed(1));
  }

  const pwmInput = document.getElementById('atTestPWM');
  const testPwm = pwmInput && pwmInput.value ? parseInt(pwmInput.value, 10) : 300;
  if (!isNaN(testPwm)) {
    localStorage.setItem('autotune_pwm', testPwm.toString());
  }

  const action = isAutotuning ? 'stop' : 'start';

  try {
    const formData = new URLSearchParams();
    formData.append('action', action);
    if (action === 'start') {
      formData.append('targetTemp', isNaN(targetTemp) ? '20.0' : targetTemp.toString());
      formData.append('testPWM', isNaN(testPwm) ? '300' : testPwm.toString());
    }

    const res = await fetch('/api/autotune', {
      method: 'POST',
      headers: { 'Content-Type': 'application/x-www-form-urlencoded' },
      body: formData.toString()
    });
    if (res.ok) {
      pollAutotuneStatus();
    }
  } catch (e) {
    alert('Error sending autotune request: ' + e);
  }
}

async function setupPidsPage() {
  try {
    const res = await fetch('/api/pids');
    if (!res.ok) return;
    const data = await res.json();

    const capEl = document.getElementById('Caption');
    if (capEl && data.Caption) capEl.textContent = data.Caption;

    const setIf = (id, val) => {
      const el = document.getElementById(id);
      if (el && val !== undefined) el.value = val;
    };
    setIf('hotPID_kP', data.hotPID_kP);
    setIf('hotPID_kI', data.hotPID_kI);
    setIf('hotPID_kD', data.hotPID_kD);
    setIf('outerPID_kP', data.outerPID_kP);
    setIf('outerPID_kIPerHour', data.outerPID_kIPerHour);
    setIf('outerPID_tdHours', data.outerPID_tdHours);
    setIf('outerPID_forecastLimitC', data.outerPID_forecastLimitC);
    setIf('outerPID_freezeRateCPerHour', data.outerPID_freezeRateCPerHour);
    setIf('cascadeMaxOffset', data.cascadeMaxOffset);

    initAutotuneTarget(data.targetTemp || data.setTemp);
    initAutotunePwm(300);

    pollAutotuneStatus();
    if (!autotuneTimer) {
      autotuneTimer = setInterval(pollAutotuneStatus, 2000);
    }
  } catch (e) {}
}

async function setupNetworkPage() {
  const timezonePreset = document.getElementById('timezonePreset');
  const timezoneCustomField = document.getElementById('timezoneCustomField');
  const timezoneCustom = document.getElementById('timezoneCustom');
  const timezoneValue = document.getElementById('timezone');
  const updateTimezoneValue = () => {
    if (!timezonePreset || !timezoneValue) return;
    const customSelected = timezonePreset.value === 'custom';
    if (timezoneCustomField) timezoneCustomField.hidden = !customSelected;
    timezoneValue.value = customSelected && timezoneCustom
      ? timezoneCustom.value
      : timezonePreset.value;
  };
  if (timezonePreset) timezonePreset.addEventListener('change', updateTimezoneValue);
  if (timezoneCustom) timezoneCustom.addEventListener('input', updateTimezoneValue);
  const networkForm = document.querySelector('.network-form');
  if (networkForm) networkForm.addEventListener('submit', updateTimezoneValue);

  try {
    const res = await fetch('/api/network');
    if (!res.ok) return;
    const data = await res.json();

    const capEl = document.getElementById('Caption');
    if (capEl && data.Caption) capEl.textContent = data.Caption;

    const setIf = (name, val) => {
      const el = document.querySelector(`input[name="${name}"]`);
      if (el && val !== undefined) el.value = val;
    };
    setIf('apSSID', data.apSSID);
    if (data.apPassword) {
      const el = document.querySelector('input[name="apPassword"]');
      if (el) el.placeholder = '(password set — leave blank to keep)';
    }
    setIf('IntSSID', data.IntSSID);
    setIf('IntPASS', data.IntPASS);
    setIf('endpointAddress', data.endpointAddress);
    setIf('endpointAccessToken', data.endpointAccessToken);
    setIf('endpointPath', data.endpointPath);
    setIf('sendInterval', data.sendInterval);
    if (timezonePreset && timezoneValue && data.timezone !== undefined) {
      const matchingPreset = Array.from(timezonePreset.options)
        .find(option => option.value === data.timezone);
      if (matchingPreset) {
        timezonePreset.value = data.timezone;
        if (timezoneCustom) timezoneCustom.value = '';
      } else {
        timezonePreset.value = 'custom';
        if (timezoneCustom) timezoneCustom.value = data.timezone;
      }
      updateTimezoneValue();
    }
    const hidden = document.getElementById('apHidden');
    if (hidden) hidden.checked = data.apHidden === true;
    const allowLocalWeb = document.getElementById('allowApWeb');
    if (allowLocalWeb) allowLocalWeb.checked = data.allowApWeb === true;
  } catch (e) {}

}

async function fetchDebug() {
  try {
    const res = await fetch('/api/debug');
    if (!res.ok) return;
    const data = await res.json();

    const setIf = (id, val) => {
      const el = document.getElementById(id);
      if (el && val !== undefined) el.textContent = val;
    };

    setIf('Caption', data.Caption);
    setIf('freeHeap', data.freeHeap);
    setIf('wifiRssi', data.wifiRssi);
    setIf('wifiIp', data.wifiIp);
    setIf('lastWifiDrop', data.lastWifiDrop);
    setIf('i2cStatus', data.i2cStatus);
    setIf('resetReason', data.resetReason);
    setIf('sensorCount', data.sensorCount);
    setIf('sensorTemps', data.sensorTemps || data.sensorCount);

    const debugLog = document.getElementById('debugLog');
    if (debugLog && data.debug !== undefined) debugLog.innerHTML = data.debug;
  } catch (e) {}
}

function setupDebugPage() {
  fetchDebug();
  setInterval(() => {
    if (!document.hidden) fetchDebug();
  }, 5000);

  const refreshBtn = document.getElementById('refreshDebugBtn');
  if (refreshBtn) {
    refreshBtn.addEventListener('click', (e) => {
      e.preventDefault();
      fetchDebug();
    });
  }

  const copyBtn = document.getElementById('copyDebugBtn');
  if (copyBtn) {
    copyBtn.addEventListener('click', async (e) => {
      e.preventDefault();
      const debugLog = document.getElementById('debugLog');
      const text = debugLog ? (debugLog.innerText || debugLog.textContent || '') : '';
      if (!text) return;

      let copied = false;
      if (navigator.clipboard && window.isSecureContext) {
        try {
          await navigator.clipboard.writeText(text);
          copied = true;
        } catch (err) {}
      }

      if (!copied) {
        try {
          const textArea = document.createElement('textarea');
          textArea.value = text;
          textArea.style.position = 'fixed';
          textArea.style.left = '-999999px';
          textArea.style.top = '-999999px';
          document.body.appendChild(textArea);
          textArea.focus();
          textArea.select();
          copied = document.execCommand('copy');
          textArea.remove();
        } catch (err) {}
      }

      if (copied) {
        copyBtn.classList.add('copied');
        setTimeout(() => {
          copyBtn.classList.remove('copied');
        }, 1800);
      }
    });
  }
}

function setupPasswordToggles() {
  document.querySelectorAll('.password-toggle').forEach((btn) => {
    btn.addEventListener('click', (e) => {
      e.preventDefault();
      const targetId = btn.getAttribute('aria-controls');
      const input = targetId ? document.getElementById(targetId) : btn.closest('.password-wrapper')?.querySelector('input');
      if (!input) return;
      const isFocused = document.activeElement === input;
      const start = input.selectionStart;
      const end = input.selectionEnd;
      const willShow = input.type === 'password';
      input.type = willShow ? 'text' : 'password';
      const label = willShow ? 'Hide password' : 'Show password';
      btn.setAttribute('aria-label', label);
      btn.setAttribute('title', label);
      btn.classList.toggle('is-visible', willShow);
      if (isFocused && start !== null && end !== null) {
        input.setSelectionRange(start, end);
      }
    });
  });
}

document.addEventListener('DOMContentLoaded', () => {
  setupNavigation();
  setupPasswordToggles();
  if (document.getElementById('boxTemp')) {
    setupIndexPage();
  } else if (document.getElementById('VoltChange')) {
    setupSettingsPage();
  } else if (document.getElementById('hotPID_kP')) {
    setupPidsPage();
  } else if (document.querySelector('input[name="apSSID"]')) {
    setupNetworkPage();
  } else if (document.getElementById('debugLog')) {
    setupDebugPage();
  }
});
