nppc/ChillerControl/Firmware/CoolerBox/CoolerBox.h

#pragma once

#include <Arduino.h>
#include <ESP8266WiFi.h>
#include <ESP8266WebServer.h>
#include <flash_hal.h>
#include <WiFiUdp.h>
#include <OneWire.h>
#include <Wire.h>
#include <DallasTemperature.h>
#include <QuickPID.h>
#include <ArduinoJson.h>
#include <EEPROM.h>
#include <LittleFS.h>

#include "Globals.h"
#include "HeatingControl.h"
#include "CoolingControl.h"
#include "TemperatureControl.h"
#include "DebugHTML.h"
#include "DoubleResetDetector.h"
#include "iSpindel.h"
#include "TelemetryQueue.h"

#define I2C_ADDRESS 0x5E
#define I2C_DATALEN 11
#define LED_WARN D0
#define ONE_WIRE_BUS D6
#define HOT_FAN D5
#define HEAT_WIRE D7
#define filterSamples 5

extern DebugHTML Debug;

extern bool I2C_PRESENT;
extern uint8_t i2c_data[I2C_DATALEN];
extern float boxTemp;
extern float HotTemp;
extern float setTemp;
extern bool useISpindelTemp;
extern byte i2c_PWM_value;
extern float measuredVoltage;
extern float measuredCurrent;
extern OneWire oneWire;
extern DallasTemperature DS18B20;
extern DeviceAddress DS18B20_adr[2];
extern uint8_t DS18B20_count;
extern unsigned long millisPIDinterval;
extern unsigned long millisSendDataInterval;
extern unsigned long millisReadI2CDataInterval;
extern unsigned long millisWIFIcheckInterval;
extern unsigned long lastWifiDropMillis;
extern volatile bool sendTelemetryNow;
extern bool wifiDropOccurred;
extern bool wifiWasConnected;
extern int ColdSensorId;
extern int HotSensorId;
extern int boxTemp_SmoothArray[filterSamples];
extern int HotTemp_SmoothArray[filterSamples];
extern DoubleResetDetector drd;
extern char apSSID[33];
extern char apPassword[65];
extern bool apHidden;
extern bool allowApWeb;
extern bool emergencyMode;
extern const char DEFAULT_TIMEZONE[];
extern char tzSetting[64];
extern const char *ssid;
extern const char *password;
extern char IntSSID[20];
extern char IntPASS[20];
extern String endpointAddress;
extern String endpointAccessToken;
extern String endpointPath;
extern int sendInterval;
extern int boxMode;
extern int boxSubMode;
extern ESP8266WebServer httpServer;
void handleUpdate();
void handleUpdateUpload();
void handleUpdateResult();

int digitalSmooth(int rawIn, int *sensSmoothArray);
void INIT_DS18B20();
void primeDS18B20();
void readDS18B20Temperatures();
bool updateDS18B20();
void resetTempConversionState();
void handleTemperatureControl();
void processControl();
void initEEPROM();
void initDefaultSettings();
void restoreSettings();
bool restoreSettingsFromEEPROM();
void saveSettings();
void initI2C();
void sendI2Cdata(bool force = false, bool sendLimits = false);
void readI2Cdata();
String getContentType(const String &filename);
bool handleFileRead(String path);
void handleFSWebServer();
void handleStatus();
void handleRoot();
void handleSettings();
void handleSettingsStore();
void handlePIDs();
void handlePIDsStore();
void handleSetTemp();
void handleStop();
void handleStart();
void handleNotFound();
void handleNetwork();
void handleNetworkStore();
void handleDebug();
void handleApiSettings();
void handleApiPIDs();
void handleAutotune();
void handleApiAutotune();
void handleApiNetwork();
void handleApiDebug();
void handleCSS();
void handleScript();
bool sendTelemetry();
bool isTelemetryUploadDue();
uint8_t telemetryBackoffLevelMinutes();
void resetTelemetryBackoff(unsigned long delayMs = 0);
bool isWebClientAllowed();
bool clockValid();
uint32_t epochSeconds();
#ifdef WIFI_DEBUG
uint8_t getTcpActivePcbCount();
uint8_t getTcpTwPcbCount();
#endif
