nppc/ChillerControl/Firmware/CoolerBox/status.cpp

#include "CoolerBox.h"

void handleStatus() {
	unsigned long val = millis();
	int tdays = val / 86400000;
	unsigned long sec = val / 1000;
	unsigned long min = sec / 60;
	int hr = min / 60;

	char buf[24];
	snprintf(buf, sizeof(buf), "%d days, %02d:%02lu:%02lu", tdays, hr % 24, min % 60, sec % 60);

	JsonDocument doc;
	doc["Caption"] = emergencyMode ? "Main Info (Emergency AP)" : "Main Info";
	doc["CurTime"] = buf;
	const bool wifiConnected = WiFi.status() == WL_CONNECTED;
	doc["wifiConnected"] = wifiConnected;
	if (wifiConnected) {
		doc["rssi"] = WiFi.RSSI();
	}
	const bool stopped = isCoolerStopped();
	const bool autoTune = isHeatingAutoTuning();
	const bool bootWait = isBootAutoStartPending();
	const unsigned long bootSec = getBootAutoStartRemainingSec();
	const bool heatingMode = autoTune || boxMode == 3 || (boxMode == 1 && boxSubMode == 3);
	doc["stopping"] = stopped;
	doc["autoTuning"] = autoTune;
	doc["pendingBootAutoStart"] = bootWait;
	doc["bootAutoStartSec"] = bootSec;
	doc["controlMode"] = boxMode == 1 ? "Automatic" : boxMode == 2 ? "Cooling only" : "Heating only";
	doc["activeProcess"] = autoTune ? "heating" : stopped ? "stopped" : heatingMode ? "heating" : "cooling";
	doc["HotTemp"] = String(HotTemp, 1);
	doc["boxTemp"] = String(boxTemp, 1);
	doc["controlTemp"] = String(getFermenterTemp(), 1);
	doc["effectiveBoxTarget"] = String(effectiveBoxTarget, 1);
	doc["cascadeHeatingGain"] = getHeatingCascadeGain();
	doc["cascadeCoolingGain"] = getCoolingCascadeGain();
	doc["cascadeBoxBaseline"] = String(getCascadeBoxBaseline(), 1);
	doc["controlSource"] = isISpindelActive() ? "Cascade (iSpindel)" : "Box Sensor";
	doc["iSpindelTemp"] = (lastISpindelMillis > 0 &&
	                       iSpindelTemperature > -50.0f &&
	                       iSpindelTemperature < 100.0f)
		? String(iSpindelTemperature, 1)
		: "--";
	doc["isISpindelActive"] = isISpindelActive();
	doc["useISpindelTemp"] = useISpindelTemp;
	doc["iSpindelInterval"] = iSpindelIntervalSec;
	doc["iSpindelRssi"] = (isISpindelActive() && iSpindelRssi != 0) ? iSpindelRssi : 0;
	doc["iSpindelPlato"] = (lastISpindelMillis > 0 && iSpindelPlato >= 0.0f)
		? String(iSpindelPlato, 2)
		: "";
	doc["fermentationComplete"] = isFermentationComplete();
	doc["fermentationHours"] = getPlatoHistoryHours();
	doc["stableHours"] = getPlatoStableHours();
	unsigned long ageSec = (lastISpindelMillis > 0) ? (millis() - lastISpindelMillis) / 1000UL : 0;
	doc["iSpindelAgeSec"] = ageSec;
	float heaterPct = (maxHotPWM > 0) ? (setHotPWM * 100.0f / (float)maxHotPWM) : 0.0f;
	doc["setHotPWM"] = String(heaterPct, 1) + "%";
	doc["setTemp"] = String(setTemp, 1);
	doc["rawSetTemp"] = String(getRampTargetTemp(), 1);
	doc["rampTargetTemp"] = String(getRampTargetTemp(), 1);
	doc["rampStepC"] = getRampStepC();
	doc["rampIntervalMinutes"] = getRampIntervalMinutes();
	doc["isSetTempRamping"] = isSetTempRamping();
	doc["Voltage"] = String(measuredVoltage, 1) + "V";
	doc["Current"] = String(measuredCurrent, 1) + "A";
	doc["Fan"] = digitalRead(HOT_FAN) ? "On" : "Off";

	String json;
	serializeJson(doc, json);
	httpServer.sendHeader("Connection", "close");
	httpServer.send(200, "application/json", json);
}
