nppc/ChillerControl/Firmware/CoolerBox/ajax.cpp

#include "CoolerBox.h"

void handleAJAXrequest() {
	unsigned long val = millis();
	int tdays = val / 86400000;
	unsigned long sec = val / 1000;
	unsigned long min = sec / 60;
	int hr = min / 60;

	char buf[20];
	sprintf(buf,"%d days, %02d:%02lu:%02lu",tdays,hr % 24,min % 60,sec % 60);
	String CurTime=String(buf);

	String Fan= (digitalRead(HOT_FAN)? "#ffd699" : "Transparent");
	String XML=F("<?xml version='1.0'?><xml>");
	XML += "<Tm>" + CurTime + "</Tm>";
	XML += "<I>" + String(I2C_PRESENT ? "I2C connected" : "I2C connection failed") + "</I>";
	XML += "<HT>" + String(HotTemp,1) + "</HT>";
	XML += "<CT>" + String(boxTemp,1) + "</CT>";
	XML += "<sV>" + String(String((int)round(setHotPWM*100.0/(float)maxHotPWM))) + "%</sV>";
	XML += "<sT>" + (stopCooler ? String(F("Stopping...")) : String(setTemp,1)) + "</sT>";
	XML += "<V>" + String(measuredVoltage,1) + "V</V>";
	XML += "<C>" + String(measuredCurrent,1) + "A</C>";
	XML += "<F>" + Fan + "</F>";
	XML += "</xml>";
	httpServer.send(200,"text/xml",XML);
}
