nppc/ChillerControl/(commit log)

2018-08-06 Initial schematic and PCB
    [ChillerControl.kicad_pcb, ChillerControl.sch]
2018-09-06 Adjust safe voltage
2018-09-06 Temperature address print
2018-09-06 Fix issue with time conversion
    [CoolerBox.ino]
2018-09-07 Added PID control
2018-09-07 Added PID settings
2018-09-07 PID loop control is tested and working
2018-09-07 STOP button for stopping the Buck slowly
2018-09-15 Case first iteration
    [Case.scad]
2018-09-15 finalize scad project. show temp sensors
    [Case.scad, CaseB.stl, CaseT.stl]
2018-09-15 implement second temperature sensor
2018-09-16 adjust fan off temp
2018-09-17 Request data from Buck every 2 seconds
2018-09-17 Enable fan on startup
2018-09-19 fix for file delete confirmation
    [FSWebServer.ino]
2018-09-24 SCAD lock
    [Lock.scad, Lock.stl]
2018-09-29 final version of lock
    [Lock.scad, Lock.stl]
2018-10-01 I2C recheck if failed
    [CoolerCover.scad, CoolerCover.stl]
2018-10-02 vent cover 2
    [CoolerCover.scad, CoolerCover.stl]
2018-10-06 I2C errors count
2019-01-14 Rework Extreme temp protection
    [CoolerBox.ino, Globals.h, handleHTML.ino]
2019-01-14 fix typo in Extrme temp detection
    [CoolerBox.ino]
2019-02-05 Change temperature via Ubidots
2019-02-06 fix stopping display issue
    [handleHTML.ino]
2019-02-06 Enable/Disable Dynamic Fan Control
2019-03-08 Add heating mode. Config
2019-03-09 Implement heating control
    [ChillerControl-2019-03-04-20-39-42.sch]
2019-03-10 Implement heating control 2
2019-03-11 interface fix. fan control fix
    [CoolerBox.ino, ajax.ino, handleHTML.ino, main.js]
2019-03-11 fix old issue with stopping display
    [ajax.ino]
2019-03-11 Send hot pwm to IoT
2019-03-12 Alfa version of heat/cool version
2019-03-13 some minor fix for http requests process
    [CoolerBox.ino, Globals.h, handleHTML.ino]
2019-03-16 fix transition between heat/cool
    [CoolerBox.ino]
2019-03-18 fix transition between heat/cool 2
    [CoolerBox.ino, sendDataIoT.ino]
2019-03-20 Implement Dynamic shange of set temperature
2019-03-20 Dynamic temperature working
2019-03-21 recalculate hot pwm value for ubidots
2019-03-22 Rework IoT connection to be more reliable
    [sendDataIoT.ino]
2019-03-22 get rid off SPIFFS to check will it resolve hangs
    [CoolerBox.ino, handleHTML.ino]
2019-03-22 fix css and script file load
    [CoolerBox.ino, Globals.h]
2019-03-23 Fix hot fan control while heating
    [CoolerBox.ino]
2021-11-08 Fix set temperature for heating
    [CoolerBox.ino, Globals.h, handleHTML.ino, sendDataIoT.ino]
2026-10-10 Remove Cooler PID and move to LittleFS
2026-10-11 fix i2c
2026-10-11 Separate i2c routines
2026-10-11 reduce eeprom writes on i2c HWBuck
2026-10-12 fix temperature readings
2026-10-12 increase time between temperature redings
2026-10-12 log heating state
2026-10-12 Migrate PID library to QuickPID
2026-10-13 Fix I2c in heating mode after cold start
2026-10-13 fix cold sensor fails
2026-10-14 Adjust modes switch behavior
2026-10-14 TX power at max
2026-10-15 Cascade PID loop implemented
2026-10-16 Cascade PID loop in readme
2026-10-16 Adjust PID logic
2026-10-16 Heater smoother change
2026-10-16 temperature loop changed bit
2026-10-21 Make Stall debug messages conditional
2026-11-06 Experimental temperature prediction
2026-11-07 Heater power displayed with more precision
2026-11-08 Heater control smother
2026-11-08 Adjust heating control little more to make it even smoother
2026-11-09 remove unwanted PID reset
2026-11-10 Test temperature handling fix
2026-11-10 Implement timed ramping of the temperature to the target
2026-11-11 more fixes to stable temperature control
2026-11-11 Another place fixed to prevent abrupt power cutoff
2026-11-12 New outer PID logic
2026-11-12 Debug temperature sensors added
2026-11-12 PID paramenters explained
2026-11-12 Fix password saving on a new device
2026-11-13 Outer PID Iparam fix
2026-11-14 Fix Stop button position
